felixmanfredi/MPE_HUB/MPE_HUB_Board/Graphics/HUB_MPE_EDGE_CUT_v4.dxf

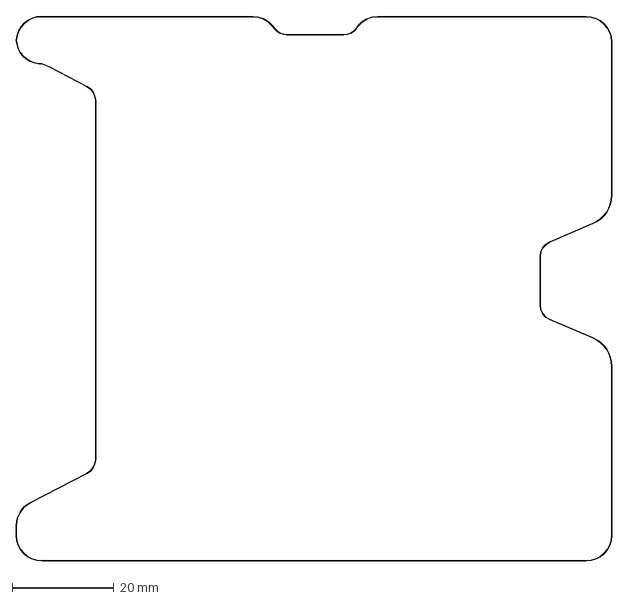
[picture p1: CAD file, 2025-07-11]
MPE_HUB_Board/Graphics/HUB_MPE_EDGE_CUT_v4.dxf
117.0 x 107.1 mm
