felixmanfredi/MPE_HUB/MPE_HUB_Board/Graphics/MPE_HUB.DXF

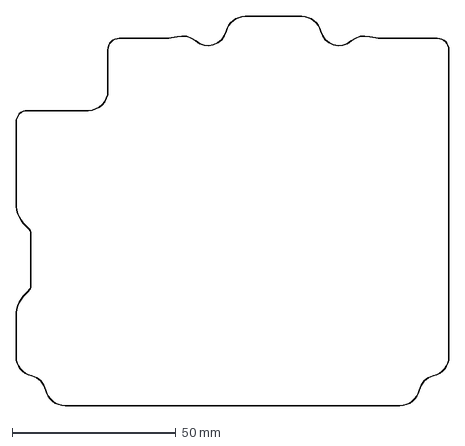
[picture p2: CAD file, 2025-04-03]
MPE_HUB_Board/Graphics/MPE_HUB.DXF
132.0 x 118.7 mm
