felixmanfredi/MPE_HUB/MPE_HUB_Board/Graphics/HUB_MPE-Edge_Cuts.dxf

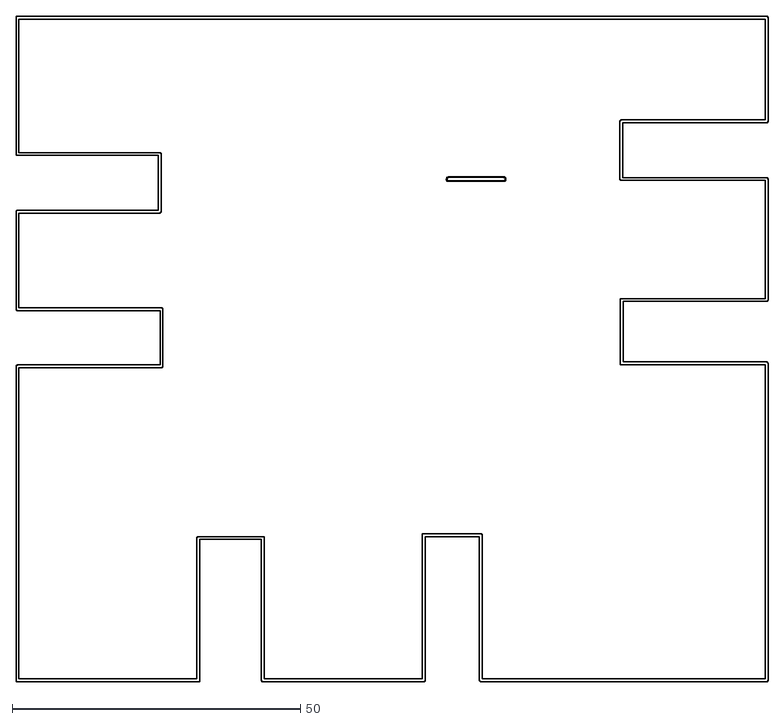
[picture p3: CAD file, 2025-04-03]
MPE_HUB_Board/Graphics/HUB_MPE-Edge_Cuts.dxf
130.5 x 115.5
