felixmanfredi/MPE_HUB/MPE_HUB_Board/Graphics/HUB_MPE_EDGE_CUT_v3.dxf

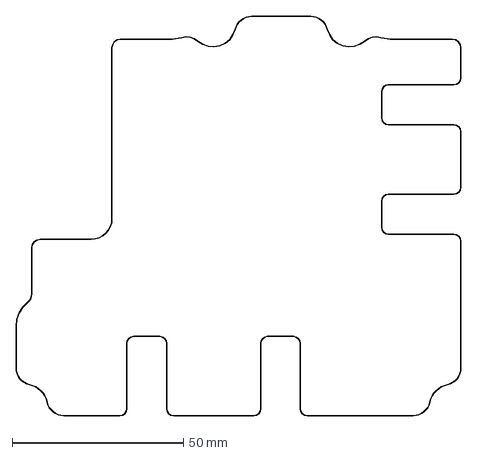
[picture p4: CAD file, 2025-04-07, an earlier design]
MPE_HUB_Board/Graphics/HUB_MPE_EDGE_CUT_v3.dxf
130.0 x 116.7 mm
