felixmanfredi/MPE_HUB/MPE_HUB_Board/Graphics/HUB_MPE_EDGE_CUT_v2.dxf

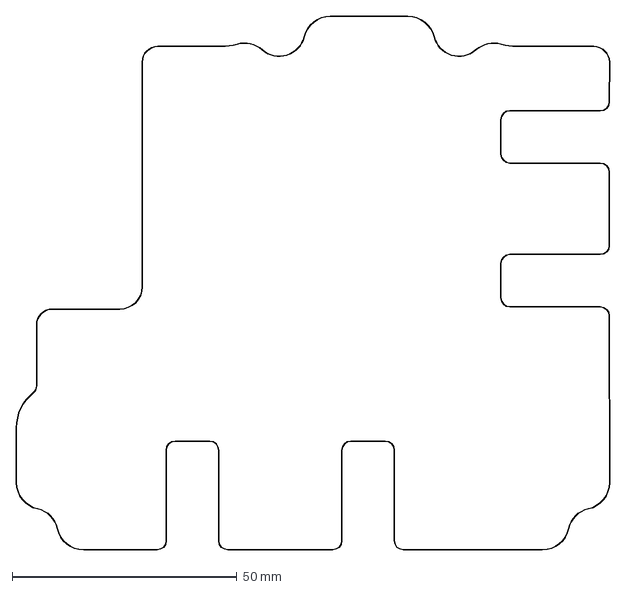
[picture p5: CAD file, 2025-04-03, an earlier design]
MPE_HUB_Board/Graphics/HUB_MPE_EDGE_CUT_v2.dxf
132.0 x 118.7 mm
