felixmanfredi/MPE_HUB/MPE_HUB_Board/HUB_MPE.kicad_pcb

## KiCad design MPE_HUB_Board/HUB_MPE.kicad_pcb (2025-07-11)

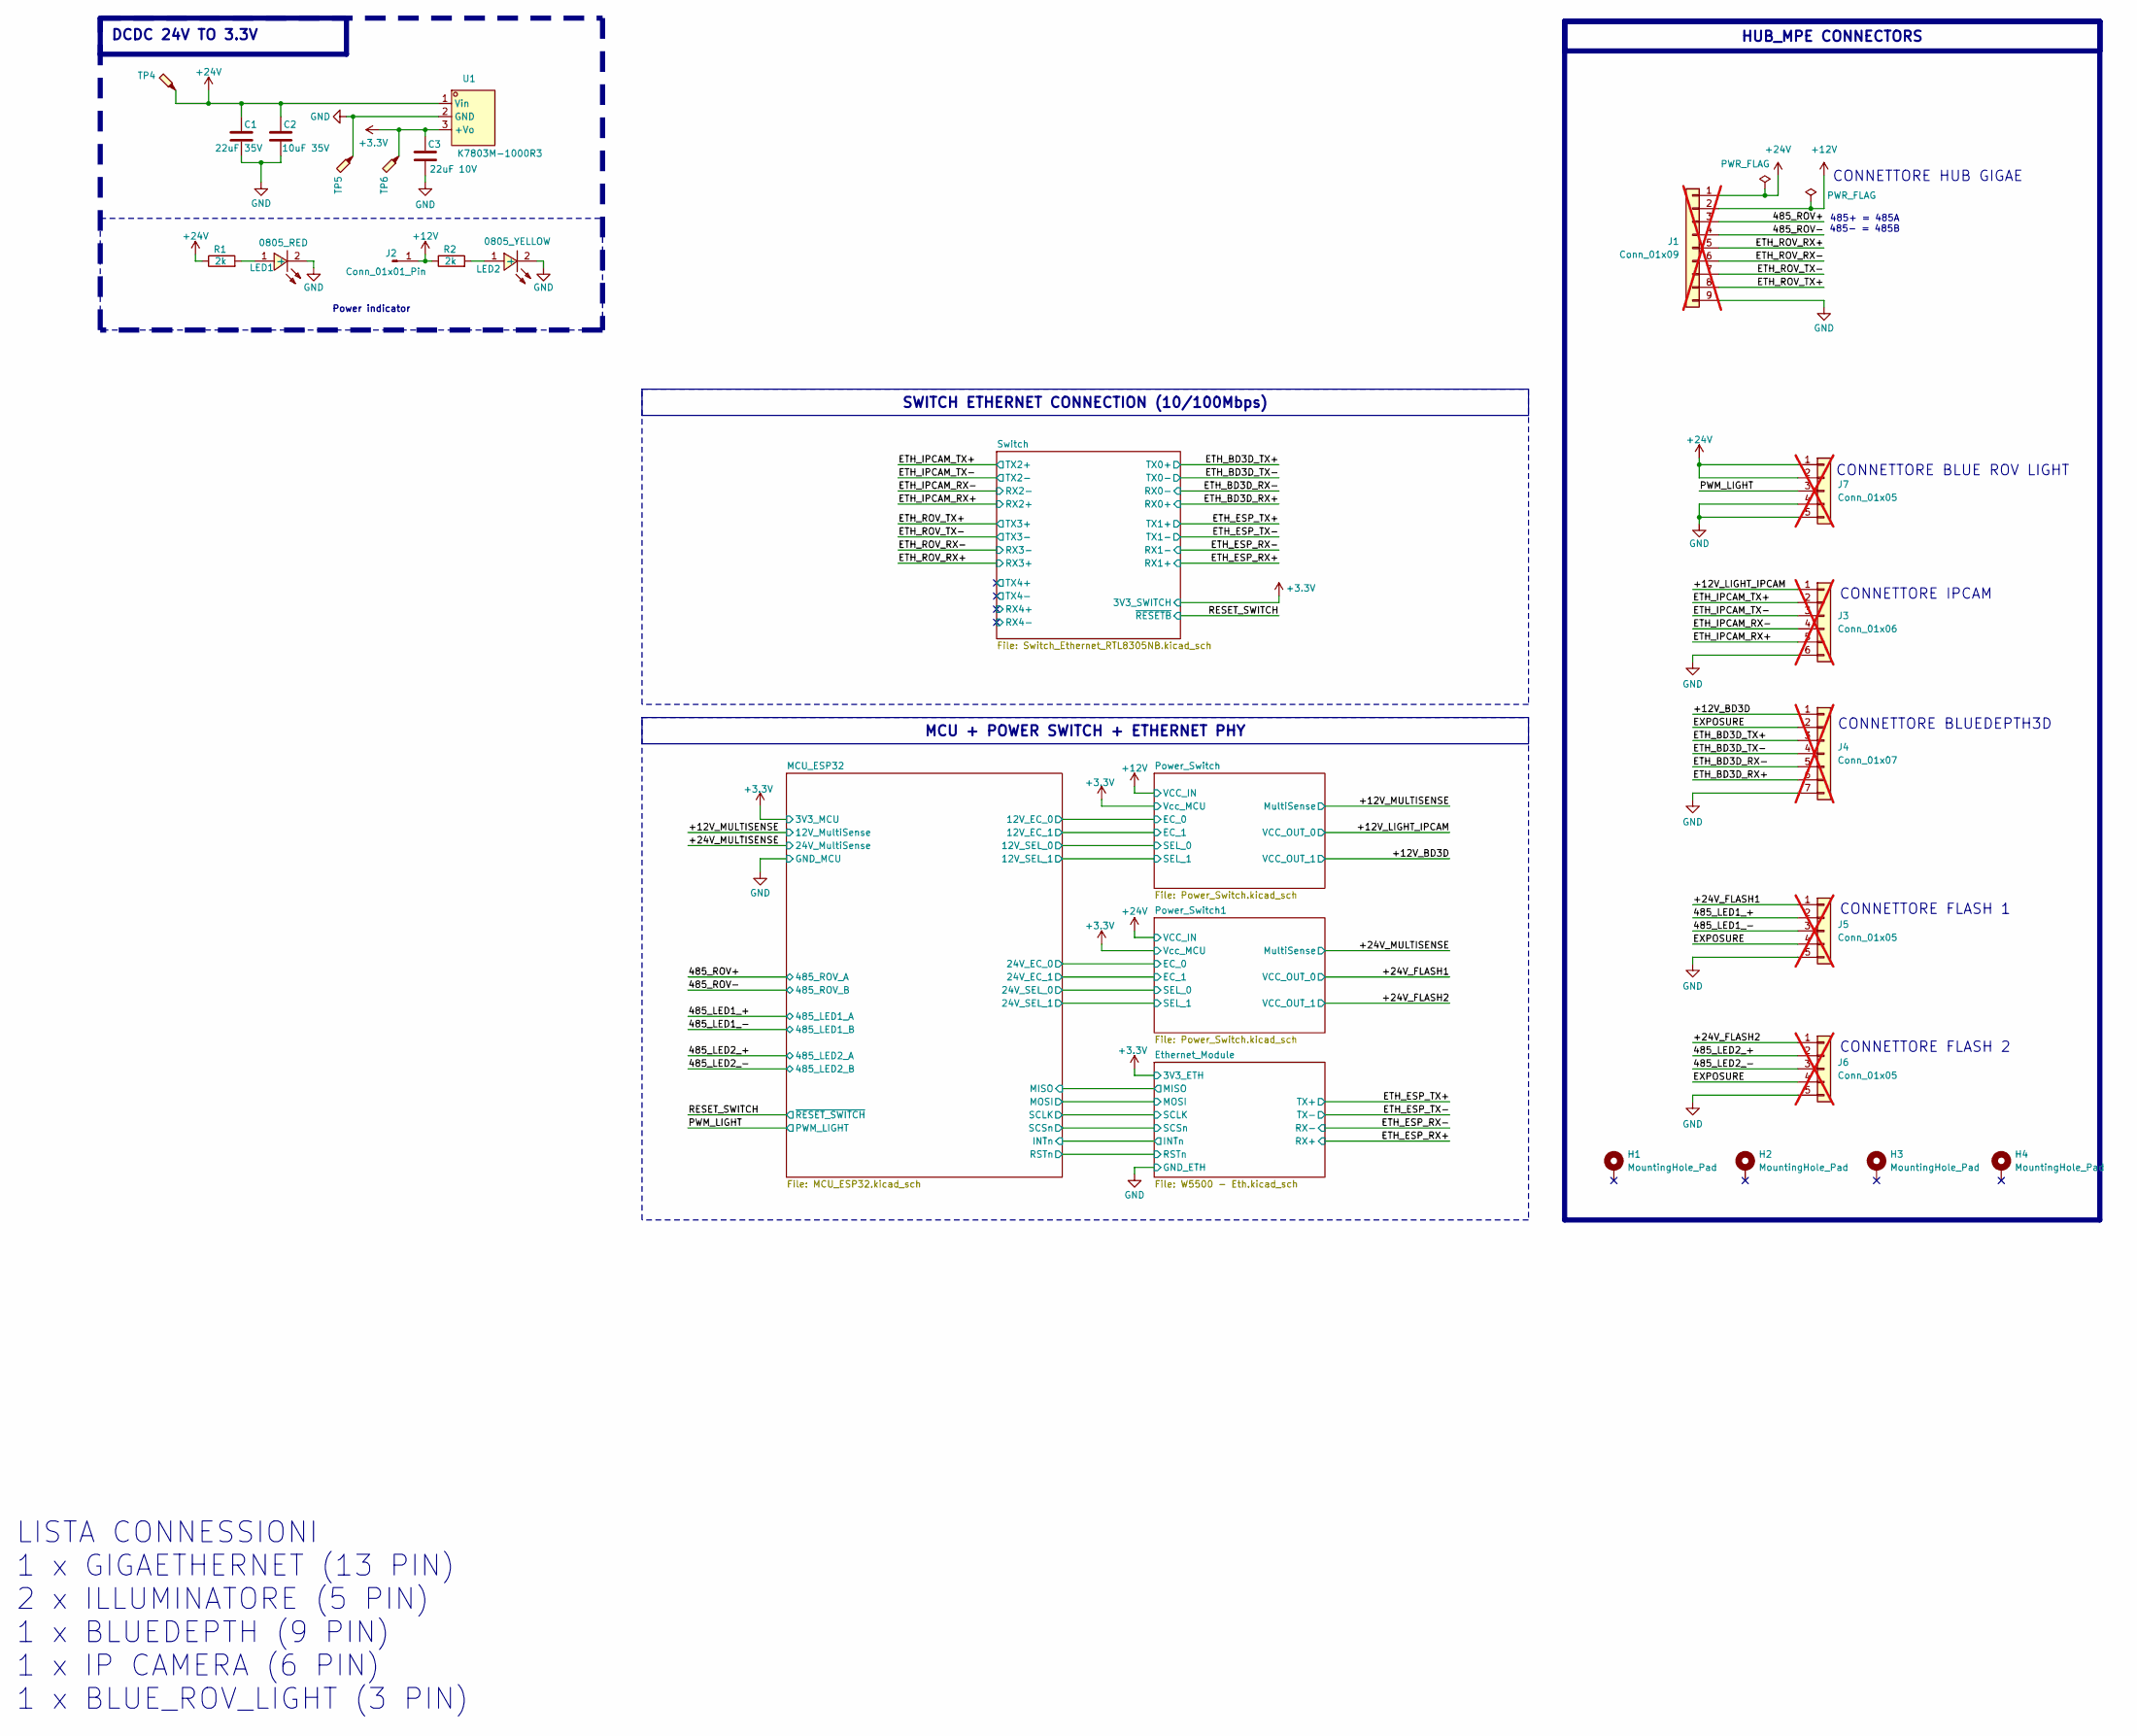
[picture p6: schematic HUB_MPE.kicad_sch]

Parts:
C1: 22uF 35V; C_1206_3216Metric; LCSC C342620
C2: 10uF 35V; C_0603_1608Metric; LCSC C194427
C3: 22uF 10V; C_0603_1608Metric; LCSC C60077
H1, H2, H3, H4: MountingHole_Pad; MountingHole_3.2mm_M3_Pad_Via
J1: Conn_01x09; JST_VH_B9P-VH-B_1x09_P3.96mm_Vertical; not fitted
J2: Conn_01x01_Pin; SolderWire-0.75sqmm_1x01_D1.25mm_OD3.5mm
J3: Conn_01x06; JST_VH_B6P-VH-B_1x06_P3.96mm_Vertical; not fitted
J4: Conn_01x07; JST_VH_B7P-VH-B_1x07_P3.96mm_Vertical; not fitted
J5, J6, J7: Conn_01x05; JST_VH_B5P-VH-B_1x05_P3.96mm_Vertical; not fitted
LED1: 0805_RED; LED0805-R-RD; LCSC Part C84256
LED2: 0805_YELLOW; LED0805-R-RD; LCSC Part C2296
R1, R2: 2k; R_0603_1608Metric; LCSC C22975
TP4, TP5, TP6: TestPoint_Probe; TEST-TH_BD2.54-P1.39; LCSC C238122
U1: K7803M-1000R3; PWRM-TH_DEXU_K78XXM-1000R3_XXXXXX; LCSC Part C2916516

Connections:
+3.3V: C3.1, TP6.1, U1.3 (+Vo); also elsewhere on the board
+12V: J1.2, J2.1, R2.1; also elsewhere on the board
+24V: C1.1, C2.1, J1.1, J7.1, J7.2, R1.1, TP4.1, U1.1 (Vin); also elsewhere on the board
/485_LED1_+: J5.2; also elsewhere on the board
/485_LED1_-: J5.3; also elsewhere on the board
/485_LED2_+: J6.2; also elsewhere on the board
/485_LED2_-: J6.3; also elsewhere on the board
/485_ROV+: J1.3; also elsewhere on the board
/485_ROV-: J1.4; also elsewhere on the board
/+12V_BD3D: J4.1; also elsewhere on the board
/+12V_LIGHT_IPCAM: J3.1; also elsewhere on the board
/+24V_FLASH1: J5.1; also elsewhere on the board
/+24V_FLASH2: J6.1; also elsewhere on the board
/ETH_BD3D_RX+: J4.6; also elsewhere on the board
/ETH_BD3D_RX-: J4.5; also elsewhere on the board
/ETH_BD3D_TX+: J4.3; also elsewhere on the board
/ETH_BD3D_TX-: J4.4; also elsewhere on the board
/ETH_IPCAM_RX+: J3.5; also elsewhere on the board
/ETH_IPCAM_RX-: J3.4; also elsewhere on the board
/ETH_IPCAM_TX+: J3.2; also elsewhere on the board
/ETH_IPCAM_TX-: J3.3; also elsewhere on the board
/ETH_ROV_RX+: J1.5; also elsewhere on the board
/ETH_ROV_RX-: J1.6; also elsewhere on the board
/ETH_ROV_TX+: J1.8; also elsewhere on the board
/ETH_ROV_TX-: J1.7; also elsewhere on the board
/EXPOSURE: J4.2, J5.4, J6.4
/PWM_LIGHT: J7.3; also elsewhere on the board
unnamed: LED1.1 (+), R1.2
unnamed: LED2.1 (+), R2.2

Notes on the sheet:
CONNETTORE FLASH 1
Power indicator
CONNETTORE HUB GIGAE
CONNETTORE IPCAM
485+ = 485A 485- = 485B
LISTA CONNESSIONI 1 x GIGAETHERNET (13 PIN) 2 x ILLUMINATORE (5 PIN) 1 x BLUEDEPTH (9 PIN) 1 x IP CAMERA (6 PIN) 1 x BLUE_ROV_LIGHT (3 PIN)
CONNETTORE BLUEDEPTH3D
CONNETTORE BLUE ROV LIGHT
CONNETTORE FLASH 2
MCU + POWER SWITCH + ETHERNET PHY
HUB_MPE CONNECTORS
SWITCH ETHERNET CONNECTION (10/100Mbps)
DCDC 24V TO 3.3V

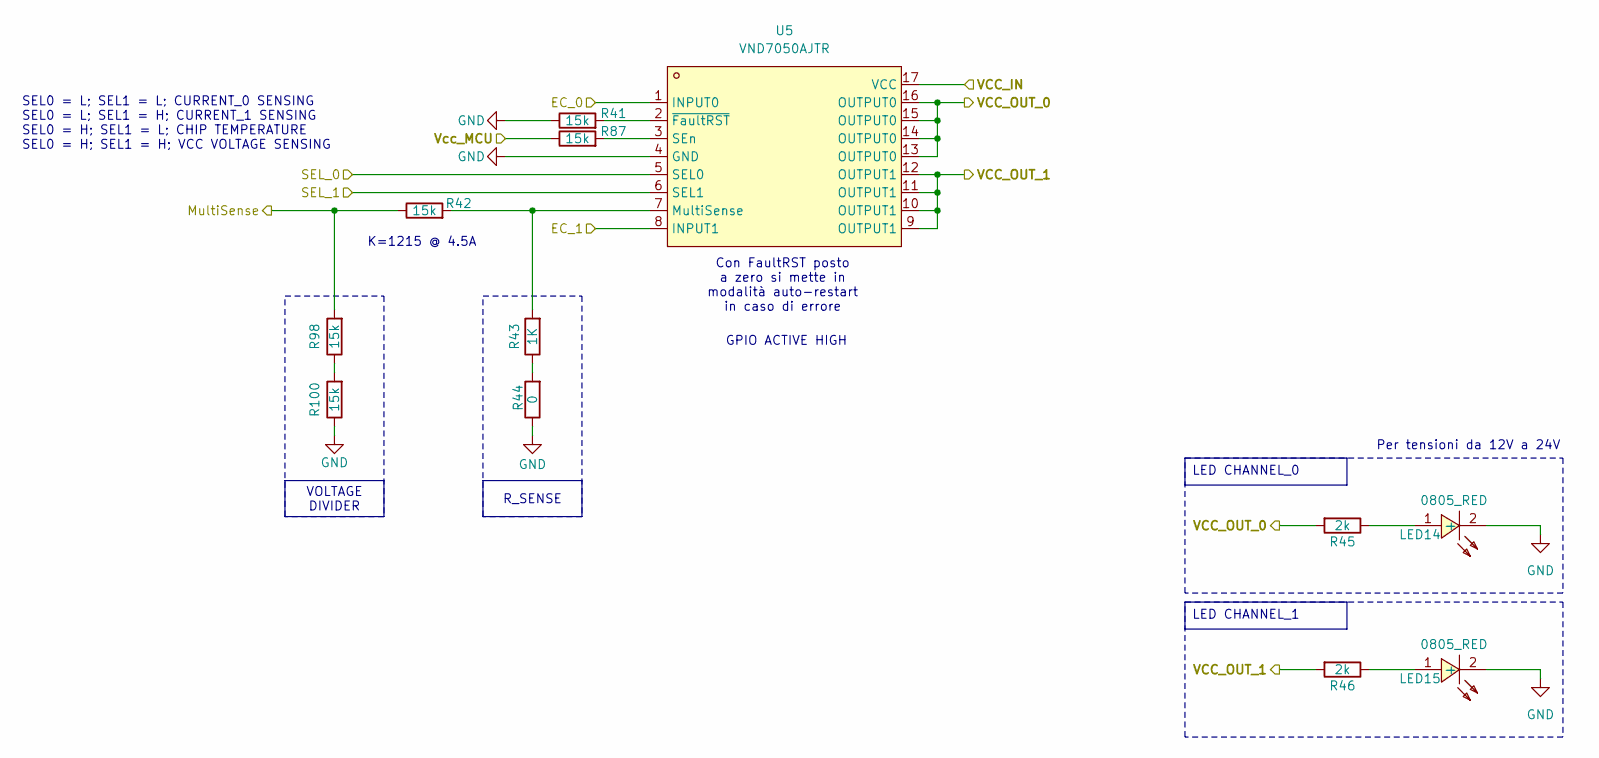
[picture p7: schematic Power_Switch.kicad_sch]

Parts:
LED14, LED15: 0805_RED; LED0805-R-RD; LCSC Part C84256
R41, R42, R87, R98, R100: 15k; R_0603_1608Metric; LCSC C22809
R43: 1K; R_0603_1608Metric; LCSC Part C21190
R44: 0; R_0603_1608Metric; LCSC C21189
R45, R46: 2k; R_0603_1608Metric; LCSC C22975
U5: VND7050AJTR; POWERSSO-16_L4.9-W3.9-P0.50-LS6.0-BL-EP; LCSC Part C443997

Connections:
+3.3V: R87.1; also elsewhere on the board
+12V: U5.17 (VCC); also elsewhere on the board
/+12V_BD3D: R46.2, U5.9 (OUTPUT1), U5.10 (OUTPUT1), U5.11 (OUTPUT1), U5.12 (OUTPUT1); also elsewhere on the board
/+12V_LIGHT_IPCAM: R45.2, U5.13 (OUTPUT0), U5.14 (OUTPUT0), U5.15 (OUTPUT0), U5.16 (OUTPUT0); also elsewhere on the board
/+12V_MULTISENSE: R42.1, R98.2; also elsewhere on the board
/MCU_ESP32/12V_EC_0: U5.1 (INPUT0); also elsewhere on the board
/MCU_ESP32/12V_EC_1: U5.8 (INPUT1); also elsewhere on the board
/MCU_ESP32/12V_SEL_0: U5.5 (SEL0); also elsewhere on the board
/MCU_ESP32/12V_SEL_1: U5.6 (SEL1); also elsewhere on the board
unnamed: LED14.1 (+), R45.1
unnamed: LED15.1 (+), R46.1
unnamed: R43.1, R44.2
unnamed: R98.1, R100.2
unnamed: R42.2, R43.2, U5.7 (MultiSense)
unnamed: R87.2, U5.3 (SEn)
unnamed: R41.2, U5.2 (~FaultRST)

Parts of its further copies:
LED16, LED17: 0805_RED; LED0805-R-RD; LCSC Part C84256
R47, R48, R88, R99, R101: 15k; R_0603_1608Metric; LCSC C22809
R49: 1K; R_0603_1608Metric; LCSC Part C21190
R50: 0; R_0603_1608Metric; LCSC C21189
R51, R52: 2k; R_0603_1608Metric; LCSC C22975
U6: VND7050AJTR; POWERSSO-16_L4.9-W3.9-P0.50-LS6.0-BL-EP; LCSC Part C443997

Connections of its further copies:
+3.3V: R88.1; also elsewhere on the board
+24V: U6.17 (VCC); also elsewhere on the board
/+24V_FLASH1: R51.2, U6.13 (OUTPUT0), U6.14 (OUTPUT0), U6.15 (OUTPUT0), U6.16 (OUTPUT0); also elsewhere on the board
/+24V_FLASH2: R52.2, U6.9 (OUTPUT1), U6.10 (OUTPUT1), U6.11 (OUTPUT1), U6.12 (OUTPUT1); also elsewhere on the board
/+24V_MULTISENSE: R48.1, R99.2; also elsewhere on the board
/MCU_ESP32/24V_EC_0: U6.1 (INPUT0); also elsewhere on the board
/MCU_ESP32/24V_EC_1: U6.8 (INPUT1); also elsewhere on the board
/MCU_ESP32/24V_SEL_0: U6.5 (SEL0); also elsewhere on the board
/MCU_ESP32/24V_SEL_1: U6.6 (SEL1); also elsewhere on the board
unnamed: LED16.1 (+), R51.1
unnamed: LED17.1 (+), R52.1
unnamed: R49.1, R50.2
unnamed: R99.1, R101.2
unnamed: R48.2, R49.2, U6.7 (MultiSense)
unnamed: R88.2, U6.3 (SEn)
unnamed: R47.2, U6.2 (~FaultRST)

Notes on the sheet:
K=1215 @ 4.5A
Per tensioni da 12V a 24V
GPIO ACTIVE HIGH
SEL0 = L; SEL1 = L; CURRENT_0 SENSING SEL0 = L; SEL1 = H; CURRENT_1 SENSING SEL0 = H; SEL1 = L; CHIP TEMPERATURE SEL0 = H; SEL1 = H; VCC VOLTAGE SENSING
Con FaultRST posto a zero si mette in modalità auto-restart in caso di errore
R_SENSE
VOLTAGE DIVIDER
LED CHANNEL_1
LED CHANNEL_0

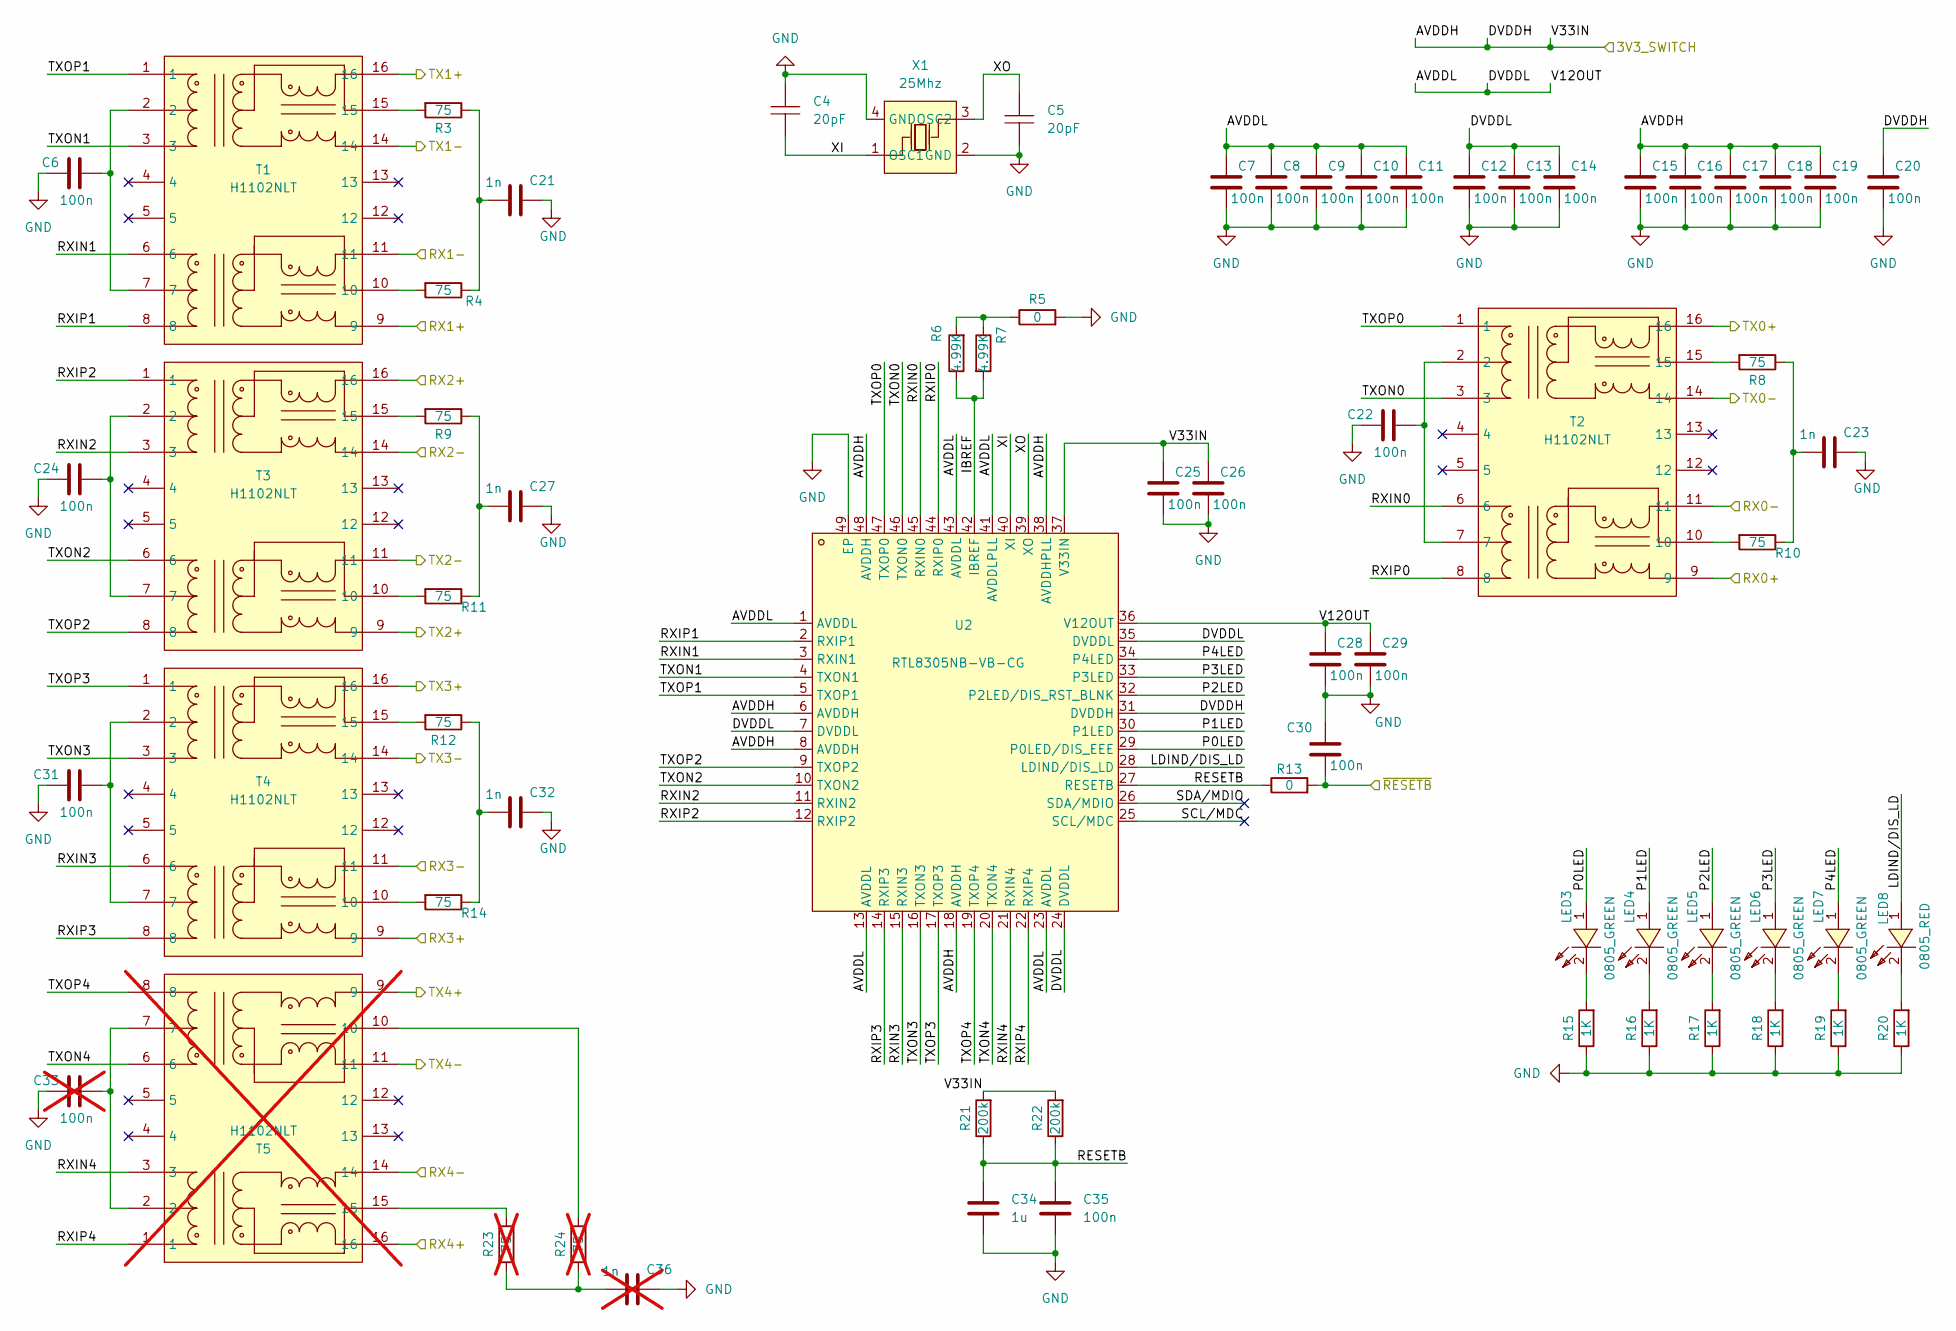
[picture p8: schematic Switch_Ethernet_RTL8305NB.kicad_sch]

Parts:
C4, C5: 20pF; C_0603_1608Metric; LCSC Part C1648
C6, C7, C8, C9, C10, C11, C12, C13, C14, C15, C16, C17, C18, C19, C20, C22, C24, C25, C26, C28, C29, C30, C31, C35: 100n; C_0603_1608Metric; LCSC Part C14663
C21, C23, C27, C32: 1n; C_0603_1608Metric; LCSC Part C1588
C33: 100n; C_0603_1608Metric; LCSC Part C14663; not fitted
C34: 1u; C_0603_1608Metric; LCSC Part C15849
C36: 1n; C_0603_1608Metric; LCSC Part C1588; not fitted
LED3, LED4, LED5, LED6, LED7: 0805_GREEN; LED0805-R-RD; LCSC Part C2297
LED8: 0805_RED; LED0805-R-RD; LCSC Part C84256
R3, R4, R8, R9, R10, R11, R12, R14: 75; R_0603_1608Metric; LCSC Part C4275
R5, R13: 0; R_0603_1608Metric; LCSC Part C21189
R6, R7: 4.99K; R_0603_1608Metric; LCSC Part C23046
R15, R16, R17, R18, R19, R20: 1K; R_0603_1608Metric; LCSC Part C21190
R21, R22: 200k; R_0603_1608Metric; LCSC Part C25811
R23, R24: 75; R_0603_1608Metric; LCSC Part C4275; not fitted
T1, T2, T3, T4: H1102NLT; XFMR-SMD_H1102NLT; LCSC Part C18584
T5: H1102NLT; XFMR-SMD_H1102NLT; LCSC Part C18584; not fitted
U2: RTL8305NB-VB-CG; QFN-48_L6.0-W6.0-P0.40-TL-EP4.4; LCSC Part C3010343
X1: 25Mhz; CRYSTAL-SMD_4P-L3.2-W2.5-BL; LCSC Part C9006

Connections:
+3.3V: C15.1, C16.1, C17.1, C18.1, C19.1, C20.1, C25.1, C26.1, R21.2, R22.2, U2.6 (AVDDH), U2.8 (AVDDH), U2.18 (AVDDH), U2.31 (DVDDH), U2.37 (V33IN), U2.38 (AVDDHPLL), U2.48 (AVDDH); also elsewhere on the board
/ETH_BD3D_RX+: T2.9; also elsewhere on the board
/ETH_BD3D_RX-: T2.11; also elsewhere on the board
/ETH_BD3D_TX+: T2.16; also elsewhere on the board
/ETH_BD3D_TX-: T2.14; also elsewhere on the board
/ETH_ESP_RX+: T1.9; also elsewhere on the board
/ETH_ESP_RX-: T1.11; also elsewhere on the board
/ETH_ESP_TX+: T1.16; also elsewhere on the board
/ETH_ESP_TX-: T1.14; also elsewhere on the board
/ETH_IPCAM_RX+: T3.16; also elsewhere on the board
/ETH_IPCAM_RX-: T3.14; also elsewhere on the board
/ETH_IPCAM_TX+: T3.9; also elsewhere on the board
/ETH_IPCAM_TX-: T3.11; also elsewhere on the board
/ETH_ROV_RX+: T4.9; also elsewhere on the board
/ETH_ROV_RX-: T4.11; also elsewhere on the board
/ETH_ROV_TX+: T4.16; also elsewhere on the board
/ETH_ROV_TX-: T4.14; also elsewhere on the board
/RESET_SWITCH: C30.2, R13.2; also elsewhere on the board
/Switch/LDIND/DIS_LD: LED8.1 (+), U2.28 (LDIND/DIS_LD)
/Switch/P0LED: LED3.1 (A), U2.29 (P0LED/DIS_EEE)
/Switch/P1LED: LED4.1 (A), U2.30 (P1LED)
/Switch/P2LED: LED5.1 (A), U2.32 (P2LED/DIS_RST_BLNK)
/Switch/P3LED: LED6.1 (A), U2.33 (P3LED)
/Switch/P4LED: LED7.1 (A), U2.34 (P4LED)
/Switch/RESETB: C34.1, C35.1, R13.1, R21.1, R22.1, U2.27 (RESETB)
/Switch/RXIN0: T2.6, U2.45 (RXIN0)
/Switch/RXIN1: T1.6, U2.3 (RXIN1)
/Switch/RXIN2: T3.3, U2.11 (RXIN2)
/Switch/RXIP0: T2.8, U2.44 (RXIP0)
/Switch/RXIP1: T1.8, U2.2 (RXIP1)
/Switch/RXIP2: T3.1, U2.12 (RXIP2)
/Switch/SCL/MDC: U2.25 (SCL/MDC)
/Switch/SDA/MDIO: U2.26 (SDA/MDIO)
/Switch/TXON0: T2.3, U2.46 (TXON0)
/Switch/TXON1: T1.3, U2.4 (TXON1)
/Switch/TXON2: T3.6, U2.10 (TXON2)
/Switch/TXOP0: T2.1, U2.47 (TXOP0)
/Switch/TXOP1: T1.1, U2.5 (TXOP1)
/Switch/TXOP2: T3.8, U2.9 (TXOP2)
/Switch/XI: C4.1, U2.40 (XI), X1.1 (OSC1)
unnamed: C6.1, T1.2, T1.7
unnamed: C21.2, R3.1, R4.1
unnamed: C22.1, T2.2, T2.7
unnamed: C24.1, T3.2, T3.7
unnamed: C27.2, R9.1, R11.1
unnamed: C32.2, R12.1, R14.1
unnamed: LED3.2 (K), R15.2
unnamed: LED4.2 (K), R16.2
unnamed: LED5.2 (K), R17.2
unnamed: LED6.2 (K), R18.2
unnamed: LED7.2 (K), R19.2
unnamed: LED8.2 (-), R20.2
unnamed: R3.2, T1.15
unnamed: R4.2, T1.10
unnamed: R8.2, T2.15
unnamed: R9.2, T3.15
unnamed: R11.2, T3.10

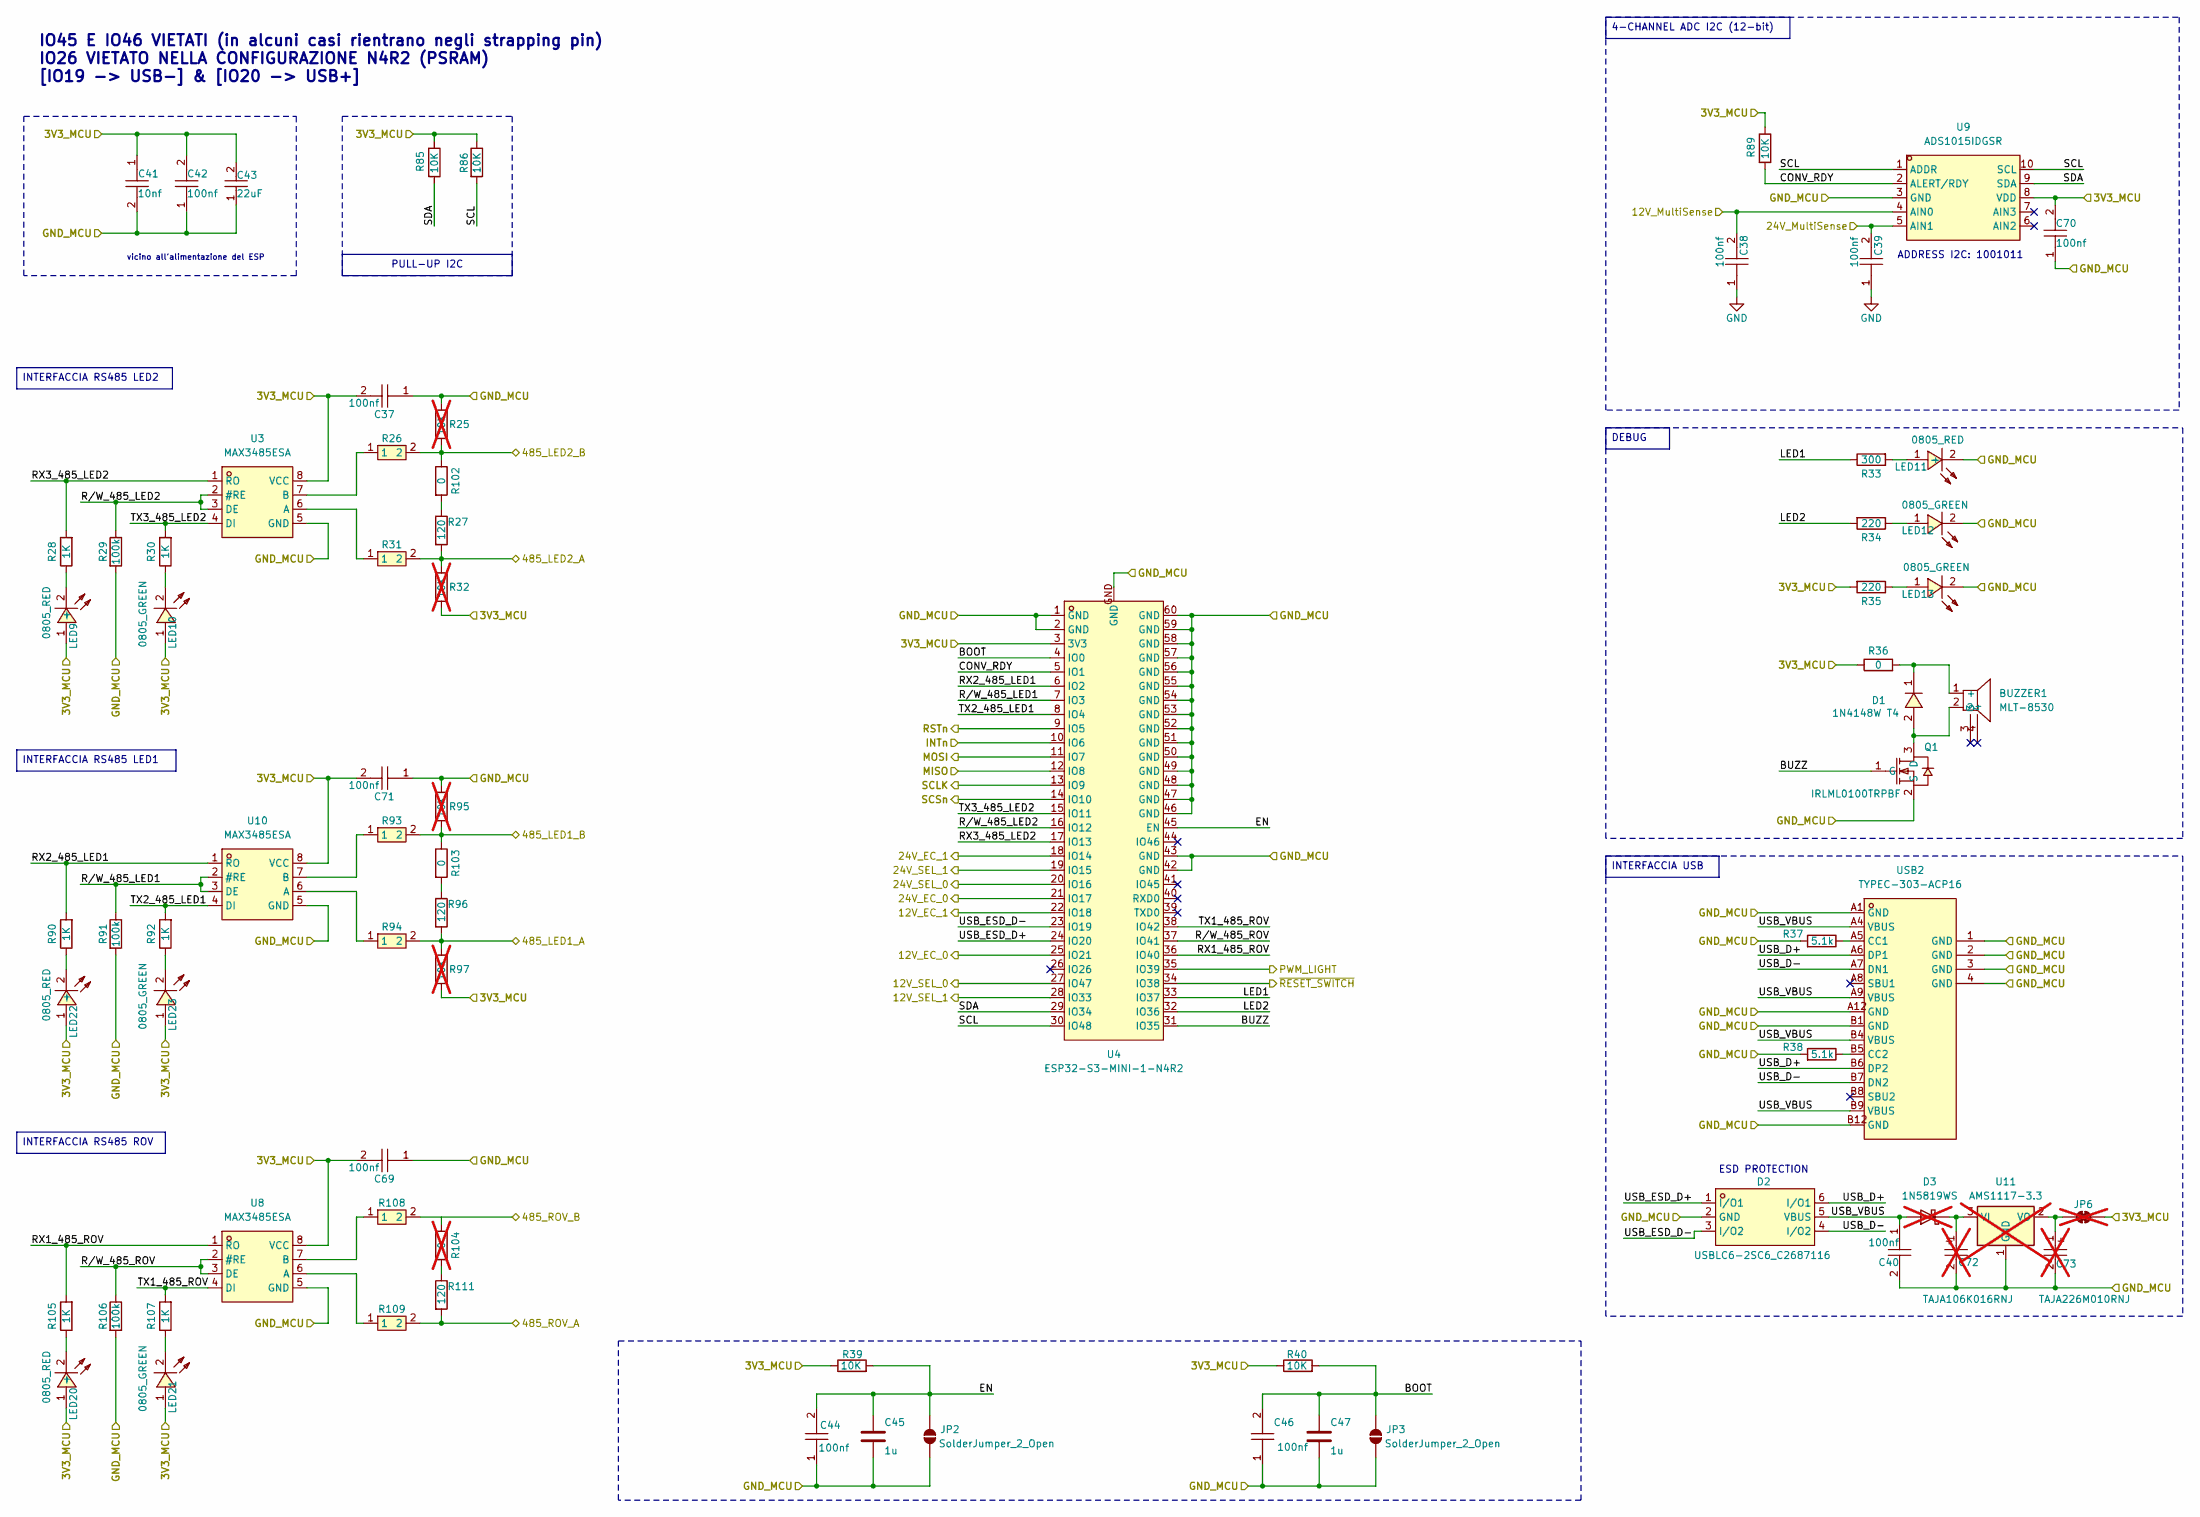
[picture p9: schematic MCU_ESP32.kicad_sch, ESP32 MCU]

Parts:
BUZZER1: MLT-8530; BUZ-SMD_4P-L8.5-W8.5-P8.50-BR; LCSC Part C94599
C37, C38, C39, C40, C42, C44, C46, C69, C70, C71: 100nf; C_0603_1608Metric; LCSC Part C14663
C41: 10nf; C_0603_1608Metric; LCSC Part C57112
C43: 22uF; C_0603_1608Metric; LCSC Part C12891
C45, C47: 1u; C_0603_1608Metric; LCSC part C15849
C72: TAJA106K016RNJ; CAP-SMD_L3.2-W1.6-RD-C7171; LCSC Part C7171; not fitted
C73: TAJA226M010RNJ; CASE-A_3216; LCSC Part C7183; not fitted
D1: 1N4148W T4; SOD-123_L2.8-W1.8-LS3.7-RD; LCSC Part C2099
D2: USBLC6-2SC6_C2687116; SOT-23-6_L2.9-W1.6-P0.95-LS2.8-BL; LCSC Part C2687116
D3: 1N5819WS; D_SOD-323; not fitted
JP2, JP3: SolderJumper_2_Open; SolderJumper-2_P1.3mm_Open_RoundedPad1.0x1.5mm
JP6: SolderJumper_2_Bridged; SolderJumper-2_P1.3mm_Bridged_RoundedPad1.0x1.5mm; not fitted
LED9, LED11, LED20, LED22: 0805_RED; LED0805-R-RD; LCSC Part C84256
LED10, LED12, LED13, LED21, LED23: 0805_GREEN; LED0805-R-RD; LCSC Part C2297
Q1: IRLML0100TRPBF; SOT-23_L2.9-W1.3-P1.90-LS2.4-BR; LCSC Part C53658
R25, R32, R95, R97: 10K; R_0603_1608Metric; LCSC Part C25804; not fitted
R26, R31, R93, R94, R108, R109: CRCW060310R0JNEAHP; R0603; LCSC Part C844519
R27, R96, R111: 120; R_0603_1608Metric; LCSC C22787
R28, R30, R90, R92, R105, R107: 1K; R_0603_1608Metric; LCSC Part C21190
R29, R91, R106: 100k; R_0603_1608Metric; LCSC Part C25803
R33: 300; R_0603_1608Metric; LCSC Part C23025
R34, R35: 220; R_0603_1608Metric; LCSC Part C22962
R36, R102, R103: 0; R_0603_1608Metric; LCSC C21189
R37, R38: 5.1k; R_0603_1608Metric
R39, R40, R85, R86, R89: 10K; R_0603_1608Metric; LCSC Part C25804
R104: 0; R_0603_1608Metric; LCSC C21189; not fitted
U3, U8, U10: MAX3485ESA; SOP-8_L5.0-W4.0-P1.27-LS6.0-BL; LCSC Part C668204
U4: ESP32-S3-MINI-1-N4R2; BULETM-SMD_ESP32-S3-MINI-1-N8; LCSC Part C3013941
U9: ADS1015IDGSR; VSSOP-10_L3.0-W3.0-P0.50-LS4.9-BL; LCSC Part C193969
U11: AMS1117-3.3; SOT-223-3_TabPin2; not fitted
USB2: TYPEC-303-ACP16; USB-C-SMD_TYPEC-303-ACP16; LCSC Part C720628

Connections:
+3.3V: C37.2, C41.1, C42.2, C43.2, C69.2, C70.2, C71.2, JP6.2 (B), LED9.1 (+), LED10.1 (A), LED20.1 (+), LED21.1 (A), LED22.1 (+), LED23.1 (A), R32.2, R35.2, R36.1, R39.1, R40.1, R85.1, R86.1, R89.1, R97.2, U3.8 (VCC), U4.3 (3V3), U8.8 (VCC), U9.8 (VDD), U10.8 (VCC); also elsewhere on the board
/485_LED1_+: R94.2, R96.2, R97.1; also elsewhere on the board
/485_LED1_-: R93.2, R95.2, R103.1; also elsewhere on the board
/485_LED2_+: R27.2, R31.2, R32.1; also elsewhere on the board
/485_LED2_-: R25.2, R26.2, R102.1; also elsewhere on the board
/485_ROV+: R109.2, R111.2; also elsewhere on the board
/485_ROV-: R108.2; also elsewhere on the board
/+12V_MULTISENSE: C38.2, U9.4 (AIN0); also elsewhere on the board
/+24V_MULTISENSE: C39.2, U9.5 (AIN1); also elsewhere on the board
/Ethernet_Module/MISO: U4.12 (IO8); also elsewhere on the board
/Ethernet_Module/MOSI: U4.11 (IO7); also elsewhere on the board
/Ethernet_Module/RSTn: U4.9 (IO5); also elsewhere on the board
/Ethernet_Module/SCLK: U4.13 (IO9); also elsewhere on the board
/Ethernet_Module//INT: U4.10 (IO6); also elsewhere on the board
/Ethernet_Module//SPI-SCS: U4.14 (IO10); also elsewhere on the board
/MCU_ESP32/12V_EC_0: U4.25 (IO21); also elsewhere on the board
/MCU_ESP32/12V_EC_1: U4.22 (IO18); also elsewhere on the board
/MCU_ESP32/12V_SEL_0: U4.27 (IO47); also elsewhere on the board
/MCU_ESP32/12V_SEL_1: U4.28 (IO33); also elsewhere on the board
/MCU_ESP32/24V_EC_0: U4.21 (IO17); also elsewhere on the board
/MCU_ESP32/24V_EC_1: U4.18 (IO14); also elsewhere on the board
/MCU_ESP32/24V_SEL_0: U4.20 (IO16); also elsewhere on the board
/MCU_ESP32/24V_SEL_1: U4.19 (IO15); also elsewhere on the board
/MCU_ESP32/BOOT: C46.2, C47.1, JP3.2 (B), R40.2, U4.4 (IO0)
/MCU_ESP32/BUZZ: Q1.1 (G), U4.31 (IO35)
/MCU_ESP32/CONV_RDY: R89.2, U4.5 (IO1), U9.2 (ALERT/RDY)
/MCU_ESP32/EN: C44.2, C45.1, JP2.2 (B), R39.2, U4.45 (EN)
/MCU_ESP32/LED1: R33.1, U4.33 (IO37)
/MCU_ESP32/LED2: R34.2, U4.32 (IO36)
/MCU_ESP32/RX1_485_ROV: R105.2, U4.36 (IO40), U8.1 (RO)
/MCU_ESP32/RX2_485_LED1: R90.2, U4.6 (IO2), U10.1 (RO)
/MCU_ESP32/RX3_485_LED2: R28.2, U3.1 (RO), U4.17 (IO13)
/MCU_ESP32/R/W_485_LED1: R91.1, U4.7 (IO3), U10.2 (#RE), U10.3 (DE)
/MCU_ESP32/R/W_485_LED2: R29.1, U3.2 (#RE), U3.3 (DE), U4.16 (IO12)
/MCU_ESP32/R/W_485_ROV: R106.1, U4.37 (IO41), U8.2 (#RE), U8.3 (DE)
/MCU_ESP32/SCL: R86.2, U4.30 (IO48), U9.1 (ADDR), U9.10 (SCL)
/MCU_ESP32/SDA: R85.2, U4.29 (IO34), U9.9 (SDA)
/MCU_ESP32/TX1_485_ROV: R107.2, U4.38 (IO42), U8.4 (DI)
/MCU_ESP32/TX2_485_LED1: R92.2, U4.8 (IO4), U10.4 (DI)
/MCU_ESP32/TX3_485_LED2: R30.2, U3.4 (DI), U4.15 (IO11)
/MCU_ESP32/USB_D+: D2.6 (I/O1), USB2.A6 (DP1), USB2.B6 (DP2)
/MCU_ESP32/USB_D-: D2.4 (I/O2), USB2.A7 (DN1), USB2.B7 (DN2)
/MCU_ESP32/USB_ESD_D+: D2.1 (I/O1), U4.24 (IO20)
/MCU_ESP32/USB_ESD_D-: D2.3 (I/O2), U4.23 (IO19)
/MCU_ESP32/USB_VBUS: C40.1, D2.5 (VBUS), D3.2 (A), USB2.A4 (VBUS), USB2.A9 (VBUS), USB2.B4 (VBUS), USB2.B9 (VBUS)
/PWM_LIGHT: U4.35 (IO39); also elsewhere on the board
/RESET_SWITCH: U4.34 (IO38); also elsewhere on the board
unnamed: BUZZER1.1 (+), D1.1 (K), R36.2
unnamed: C72.1, D3.1 (K), U11.3 (VI)
unnamed: C73.1, JP6.1 (A), U11.2 (VO)
unnamed: BUZZER1.2, D1.2 (A), Q1.3 (D)
unnamed: LED9.2 (-), R28.1
unnamed: LED10.2 (K), R30.1
unnamed: LED11.1 (+), R33.2
unnamed: LED12.1 (A), R34.1
unnamed: LED13.1 (A), R35.1
unnamed: LED20.2 (-), R105.1
unnamed: LED21.2 (K), R107.1
unnamed: LED22.2 (-), R90.1
unnamed: LED23.2 (K), R92.1
unnamed: R27.1, R102.2
unnamed: R96.1, R103.2
unnamed: R104.2, R111.1
unnamed: R31.1, U3.6 (A)
unnamed: R26.1, U3.7 (B)
unnamed: R109.1, U8.6 (A)
unnamed: R108.1, U8.7 (B)
unnamed: R94.1, U10.6 (A)
unnamed: R93.1, U10.7 (B)
unnamed: R37.1, USB2.A5 (CC1)
unnamed: R38.1, USB2.B5 (CC2)

Notes on the sheet:
ESD PROTECTION
vicino all'alimentazione del ESP
IO45 E IO46 VIETATI (in alcuni casi rientrano negli strapping pin) IO26 VIETATO NELLA CONFIGURAZIONE N4R2 (PSRAM) [IO19 -> USB-] & [IO20 -> USB+]
ADDRESS I2C: 1001011
INTERFACCIA RS485 ROV
4-CHANNEL ADC I2C (12-bit)
DEBUG
INTERFACCIA RS485 LED2
PULL-UP I2C
INTERFACCIA RS485 LED1
INTERFACCIA USB
