felixmanfredi/MPE_HUB/MPE_HUB_Board/HUB_MPE.kicad_pcb

## KiCad design MPE_HUB_Board/HUB_MPE.kicad_pcb (continued)

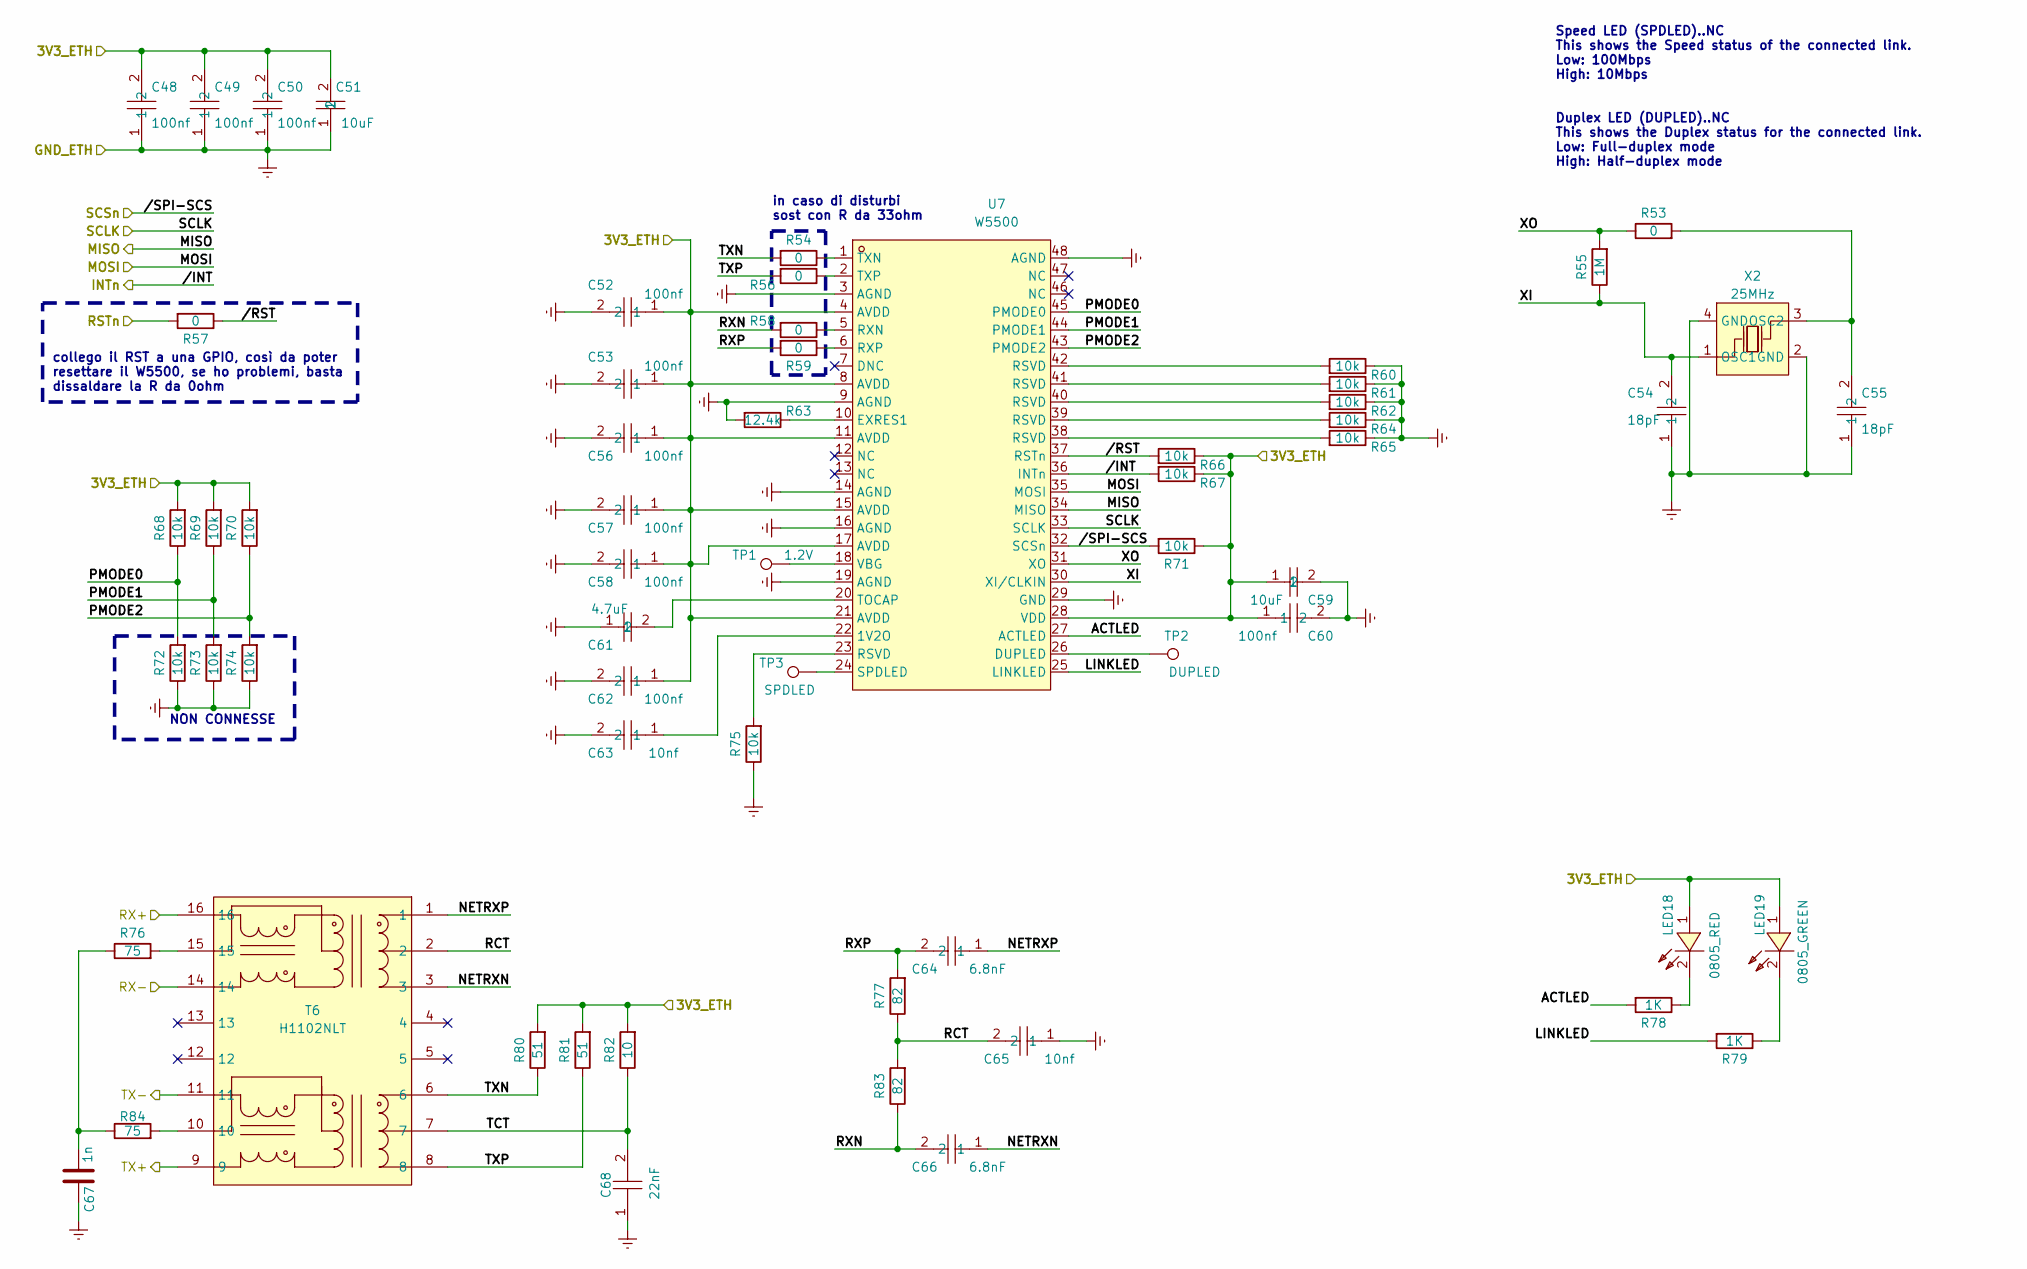
[picture p10: schematic W5500 - Eth.kicad_sch, W5500 SPI ETH]

Parts:
C48, C49, C50, C52, C53, C56, C57, C58, C60, C62: 100nf; C_0603_1608Metric; LCSC Part C14663
C51, C59: 10uF; C_0603_1608Metric; LCSC Part C440198
C54, C55: 18pF; C_0603_1608Metric; LCSC Part C165734
C61: 4.7uF; C_0603_1608Metric; LCSC Part C1779
C63, C65: 10nf; C_0603_1608Metric; LCSC Part C57112
C64, C66: 6.8nF; C_0603_1608Metric; LCSC Part C1631
C67: 1n; C_0603_1608Metric; LCSC Part C1588
C68: 22nF; C_0603_1608Metric; LCSC Part C21122
LED18: 0805_RED; LED0805-R-RD; LCSC Part C84256
LED19: 0805_GREEN; LED0805-R-RD; LCSC Part C2297
R53, R54, R56, R57, R58, R59: 0; R_0603_1608Metric; LCSC Part C21189
R55: 1M; R_0603_1608Metric; LCSC Part C105578
R60, R61, R62, R64, R65, R66, R67, R68, R69, R70, R71, R72, R73, R74, R75: 10k; R_0603_1608Metric; LCSC Part C25804
R63: 12.4k; R_0603_1608Metric; LCSC Part C413726
R76, R84: 75; R_0603_1608Metric; LCSC Part C4275
R77, R83: 82; R_0603_1608Metric; LCSC Part C23255
R78, R79: 1K; R_0603_1608Metric; LCSC Part C21190
R80, R81: 51; R_0603_1608Metric; LCSC Part C2074217
R82: 10; R_0603_1608Metric; LCSC Part C510088
T6: H1102NLT; XFMR-SMD_H1102NLT; LCSC Part C18584
TP1: 1.2V; TestPoint_Pad_D1.0mm
TP2: DUPLED; TestPoint_Pad_D1.0mm
TP3: SPDLED; TestPoint_Pad_D1.0mm
U7: W5500; LQFP-48_L7.0-W7.0-P0.50-LS9.0-BL; LCSC Part C32843
X2: 25MHz; CRYSTAL-SMD_4P-L3.2-W2.5-BL; LCSC Part C70593

Connections:
+3.3V: C48.2, C49.2, C50.2, C51.2, C52.1, C53.1, C56.1, C57.1, C58.1, C59.1, C60.1, C62.1, LED18.1 (+), LED19.1 (A), R66.1, R67.1, R68.2, R69.2, R70.2, R71.1, R80.2, R81.2, R82.2, U7.4 (AVDD), U7.8 (AVDD), U7.11 (AVDD), U7.15 (AVDD), U7.17 (AVDD), U7.21 (AVDD), U7.28 (VDD); also elsewhere on the board
/ETH_ESP_RX+: T6.16; also elsewhere on the board
/ETH_ESP_RX-: T6.14; also elsewhere on the board
/ETH_ESP_TX+: T6.9; also elsewhere on the board
/ETH_ESP_TX-: T6.11; also elsewhere on the board
/Ethernet_Module/ACTLED: R78.2, U7.27 (ACTLED)
/Ethernet_Module/LINKLED: R79.2, U7.25 (LINKLED)
/Ethernet_Module/MISO: U7.34 (MISO); also elsewhere on the board
/Ethernet_Module/MOSI: U7.35 (MOSI); also elsewhere on the board
/Ethernet_Module/NETRXN: C66.1, T6.3
/Ethernet_Module/NETRXP: C64.1, T6.1
/Ethernet_Module/PMODE0: R68.1, R72.2, U7.45 (PMODE0)
/Ethernet_Module/PMODE1: R69.1, R73.2, U7.44 (PMODE1)
/Ethernet_Module/PMODE2: R70.1, R74.2, U7.43 (PMODE2)
/Ethernet_Module/RCT: C65.2, R77.1, R83.2, T6.2
/Ethernet_Module/RSTn: R57.2; also elsewhere on the board
/Ethernet_Module/RXN: C66.2, R58.2, R83.1
/Ethernet_Module/RXP: C64.2, R59.2, R77.2
/Ethernet_Module/SCLK: U7.33 (SCLK); also elsewhere on the board
/Ethernet_Module/TCT: C68.2, R82.1, T6.7
/Ethernet_Module/TXN: R54.2, R80.1, T6.6
/Ethernet_Module/TXP: R56.2, R81.1, T6.8
/Ethernet_Module/XI: C54.2, R55.1, U7.30 (XI/CLKIN), X2.1 (OSC1)
/Ethernet_Module/XO: R53.1, R55.2, U7.31 (XO)
/Ethernet_Module//INT: R67.2, U7.36 (INTn); also elsewhere on the board
/Ethernet_Module//RST: R57.1, R66.2, U7.37 (RSTn)
/Ethernet_Module//SPI-SCS: R71.2, U7.32 (SCSn); also elsewhere on the board
unnamed: C67.2, R76.1, R84.1
unnamed: LED18.2 (-), R78.1
unnamed: LED19.2 (K), R79.1
unnamed: R60.2, U7.42 (RSVD)
unnamed: R61.2, U7.41 (RSVD)
unnamed: R62.2, U7.40 (RSVD)
unnamed: R64.2, U7.39 (RSVD)
unnamed: R65.2, U7.38 (RSVD)
unnamed: R75.2, U7.23 (RSVD)
unnamed: R76.2, T6.15
unnamed: R84.2, T6.10
unnamed: C63.1, U7.22 (1V2O)
unnamed: TP2.1, U7.26 (DUPLED)
unnamed: R63.1, U7.10 (EXRES1)
unnamed: R58.1, U7.5 (RXN)
unnamed: R59.1, U7.6 (RXP)
unnamed: TP3.1, U7.24 (SPDLED)
unnamed: C61.2, U7.20 (TOCAP)
unnamed: R54.1, U7.1 (TXN)
unnamed: R56.1, U7.2 (TXP)
unnamed: TP1.1, U7.18 (VBG)
unnamed: C55.2, R53.2, X2.3 (OSC2)

Notes on the sheet:
collego il RST a una GPIO, così da poter resettare il W5500, se ho problemi, basta dissaldare la R da 0ohm
in caso di disturbi sost con R da 33ohm
NON CONNESSE
Speed LED (SPDLED)..NC This shows the Speed status of the connected link. Low: 100Mbps High: 10Mbps Duplex LED (DUPLED)..NC This shows the Duplex status for the connected link. Low: Full-duplex mode High: Half-duplex mode

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
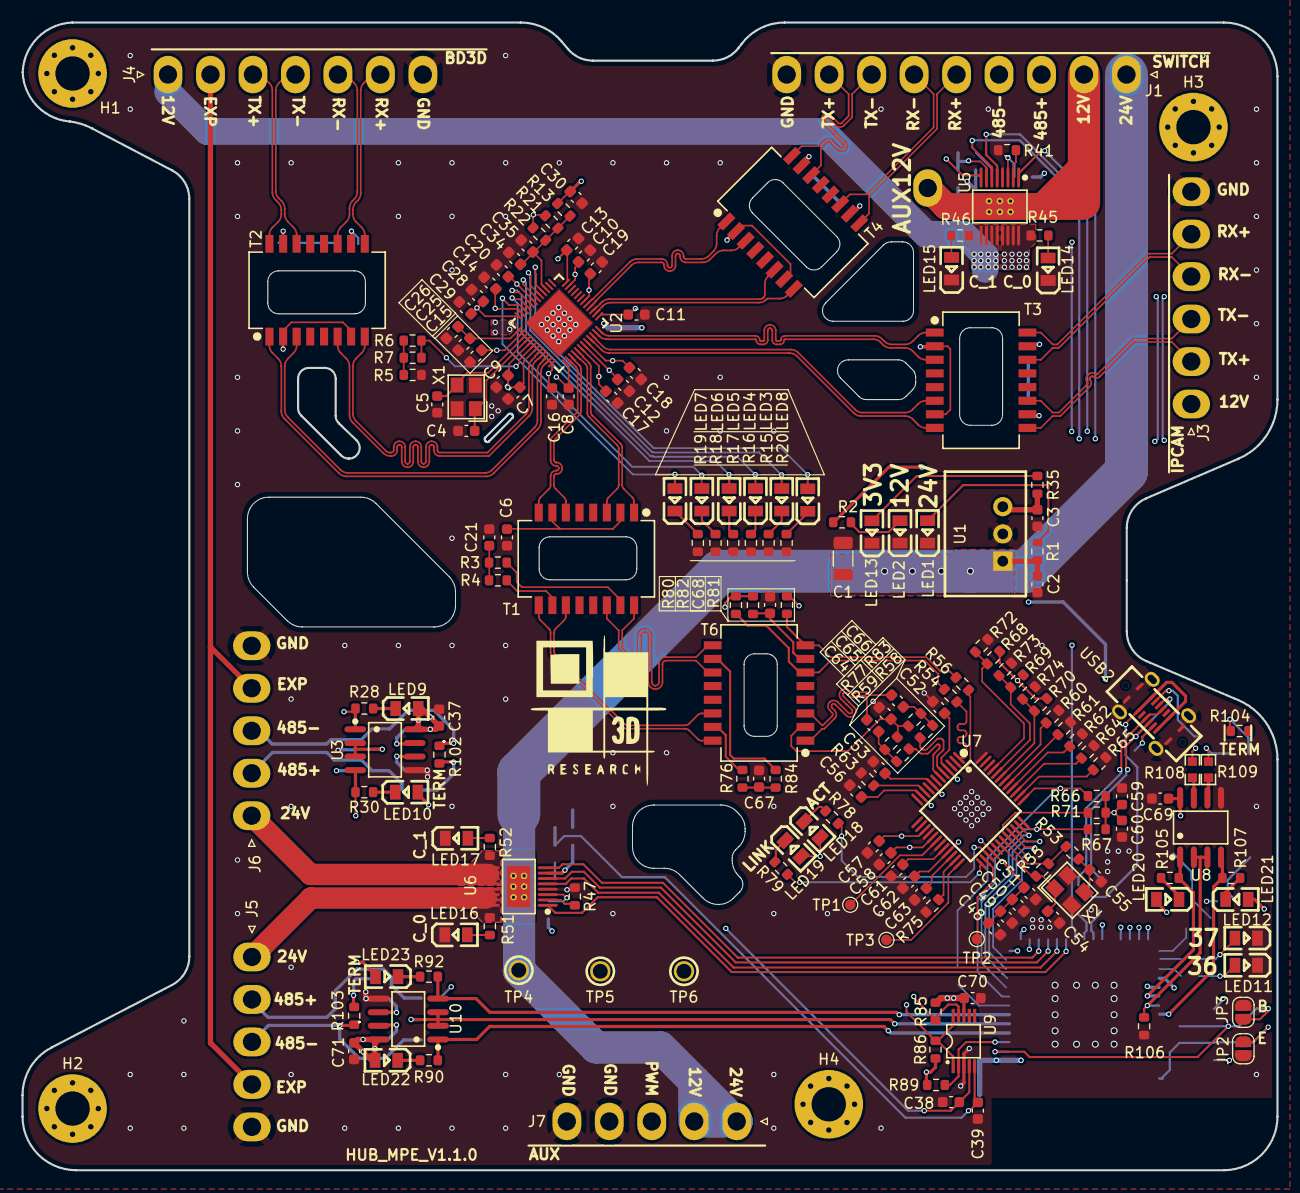
[picture p11: board HUB_MPE.kicad_pcb from above]

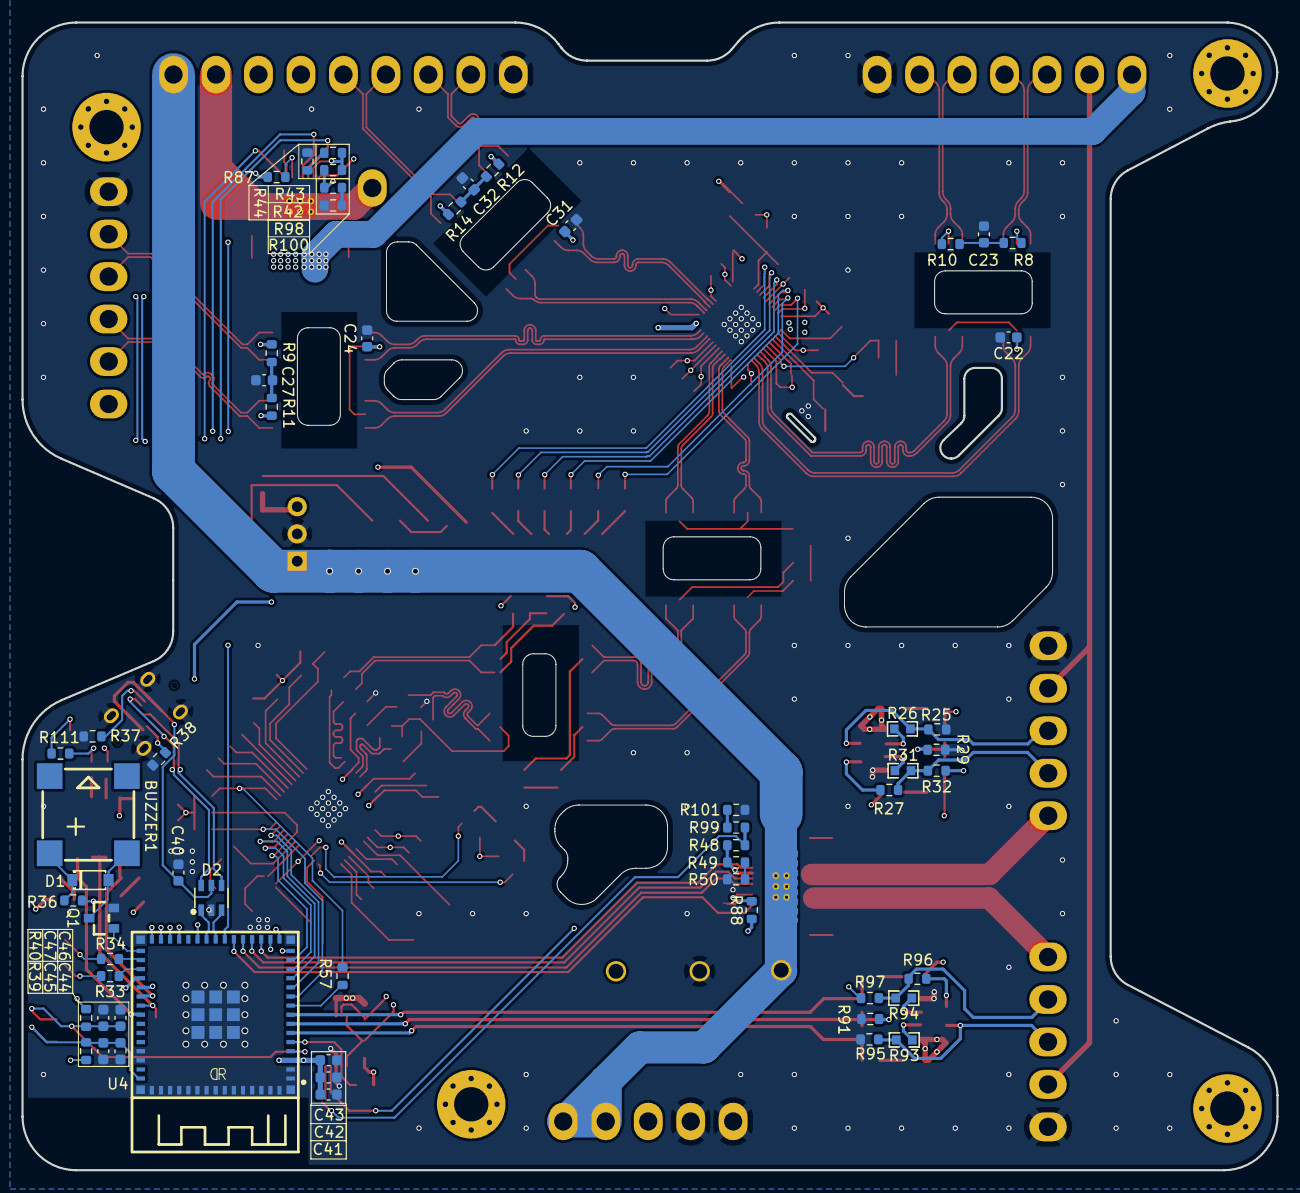
[picture p12: board HUB_MPE.kicad_pcb from below]

Board: 4 copper layers, 117.0 x 107.0 mm, 241 parts (58 on the bottom side), 197 nets.
