felixmanfredi/MPE_HUB/(commit log)

2025-04-03 PCB + PCBA
    Schematic, PCB, BOM, Gerber
    [BOM-HUB_MPE.csv, HUB_MPE-Edge_Cuts.dxf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]
2025-04-07 Riadattamento dimensioni scheda
    Offset verso l'interno di 1 mm per ingombri meccanici
    [CPL-HUB_MPE.csv, HUB_MPE-CuBottom.gbr, HUB_MPE-CuIn1.gbr, HUB_MPE-CuIn2.gbr, HUB_MPE-CuTop.gbr, HUB_MPE-EdgeCuts.gbr, HUB_MPE-MaskBottom.gbr, HUB_MPE-MaskTop.gbr]
2025-04-24 Primo Firmware MPE_HUB
    [HUB_MPE.kicad_pcb]
2025-05-08 Implementazione 485 e modifiche per test a banco
    [partitions_table.csv]
2025-05-16 Aggiunta setup per angular
    [partitions_table.csv]
2025-05-26 Implementazione server e richieste POST/GET
    [HUB_MPE.kicad_pcb, HUB_MPE.kicad_sch, MCU_ESP32.kicad_sch, Switch_Ethernet_RTL8305NB.kicad_sch]
2025-05-28 Versione WiFi completa
    [HUB_MPE.kicad_sch, MCU_ESP32.kicad_sch, Switch_Ethernet_RTL8305NB.kicad_sch]
2025-05-30 (In fase di sviluppo) implementazione ethernet SPI
2025-06-04 Versione WiFi + Ethernet (04/06/2025)
    [HUB_MPE.kicad_sch, MCU_ESP32.kicad_sch, Switch_Ethernet_RTL8305NB.kicad_sch]
2025-06-11 update 11/06/2025
    [HUB_MPE.kicad_sch, MCU_ESP32.kicad_sch, Switch_Ethernet_RTL8305NB.kicad_sch]
2025-06-20 Risolto problema reset (Nel firmware V2)
    [HUB_MPE.kicad_sch, MCU_ESP32.kicad_sch, MOSFET_CTRL.kicad_sch, Power_Switch.kicad_sch, Switch_Ethernet_RTL8305NB.kicad_sch, W5500 - Eth.kicad_sch]
2025-07-04 Update 04/07/2025
    [HUB_MPE.kicad_sch, MCU_ESP32.kicad_sch, MOSFET_CTRL.kicad_sch, Power_Switch.kicad_sch, Switch_Ethernet_RTL8305NB.kicad_sch]
2025-07-08 Update 08/07/2025
    [HUB_MPE.kicad_pcb, HUB_MPE.kicad_sch, MCU_ESP32.kicad_sch, Power_Switch.kicad_sch, Switch_Ethernet_RTL8305NB.kicad_sch]
2025-07-11 HUB Hardware V1.1.0
    [HUB_MPE.kicad_pcb, HUB_MPE.kicad_sch, HUB_MPE_EDGE_CUT_v4.dxf, MCU_ESP32.kicad_sch, Power_Switch.kicad_sch, Switch_Ethernet_RTL8305NB.kicad_sch, W5500 - Eth.kicad_sch]
2025-07-18 Update 18/07/2025
    [HUB_MPE.kicad_sch, MCU_ESP32.kicad_sch, Switch_Ethernet_RTL8305NB.kicad_sch]
2025-07-28 update 28/07/2025
    [BOM-HUB_MPE.csv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]
2025-08-08 Update 08/08/2025
    [BOM-HUB_MPE.csv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]
2025-09-05 Prima versione stabile HUB_V1.1
    [partition.csv]
2025-09-24 update 24/09/2025
    [partition_table.csv]
2025-10-10 update 10/10/2025
    [partition_table.csv]
2025-10-21 Stable firmware version 1.3.2
    Introduced a new 'flash' function and button in the UI for lamp control. Updated firmware logic to track torch mode status and improved lamp ID validation. Refactored web server endpoints for lamp control and updated system status serialization to include torch mode. Minor code and comment improvements for clarity.
